edsonpetrinijr/pintura/fotos-referencia/pintura-03.jpg

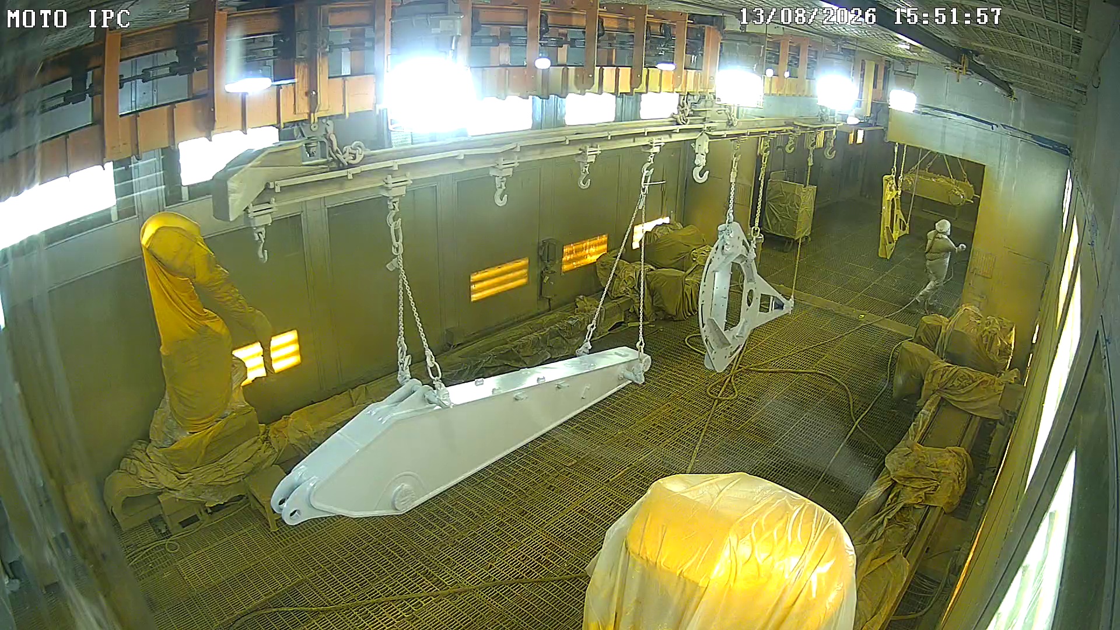
fotos-referencia/pintura-03.jpg
