edsonpetrinijr/pintura/fotos-referencia/pintura-01.jpg

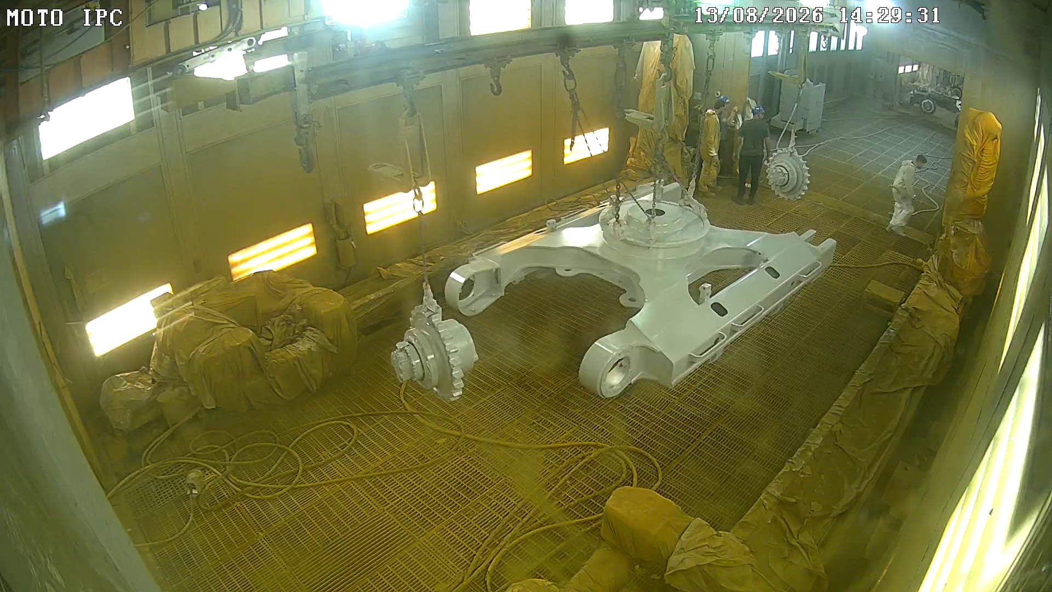
fotos-referencia/pintura-01.jpg
