edsonpetrinijr/pintura/fotos-referencia/pintura-02.jpg

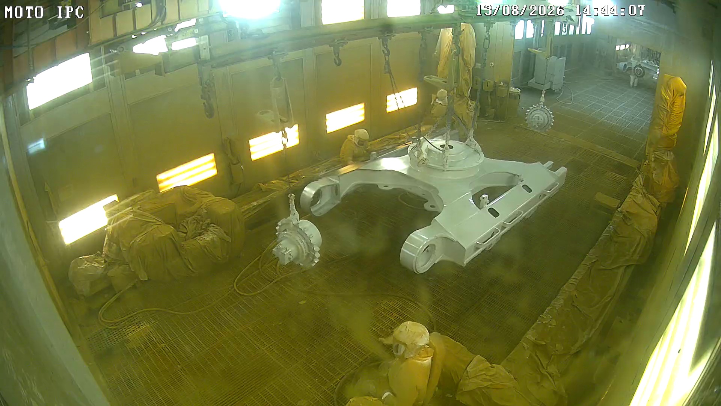
fotos-referencia/pintura-02.jpg
