edsonpetrinijr/pintura/modelos/5958940-01-STICK AS (View).stp

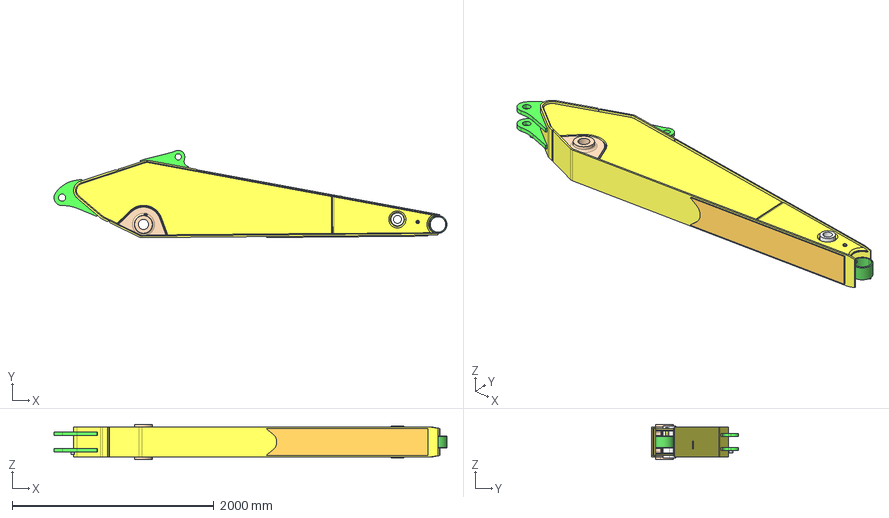
[picture p4: CAD file, 2026-08-14]
modelos/5958940-01-STICK AS (View).stp
3895.9 x 866.1 x 349.0 mm
5824531_VG01_00_PLATE
5824530_VG01_00_PLATE
5824527_VG01_01_PLATE
5824528_VG01_01_PLATE
6358060_VG01_00_PLATE
6358061_VG01_00_PLATE
5824532_VG01_01_PLATE
5824529_VG01_01_PLATE
6358064_VG01_00_PLATE x 2
6358056_VG01_00_PLATE x 2
4835117_01_TUBE
4835116_03_BOSS x 2
4719366_VG01_03_PLATE
4414043_01_PLATE x 2
4i1232_03_PLATE x 4
4719367_02_PLATE x 5
5388532_VG01_00_PLATE x 2
6c1886_m_00_PLATE
5806918_00_BOSS
4i1233_05_BOSS x 2
4i0523_03_TUBE
4719410_01_BOSS
1304477_01_PLATE
