edsonpetrinijr/pintura/modelos/6337098-03-FRAME AS-UPPER (View).stp

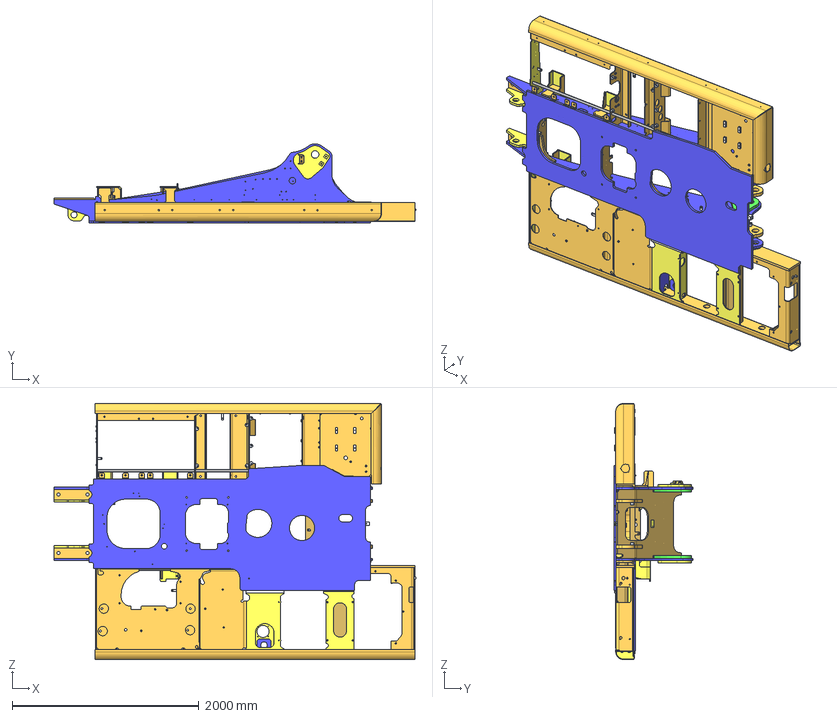
[picture p6: CAD file, 2026-08-14]
modelos/6337098-03-FRAME AS-UPPER (View).stp
3872.0 x 849.3 x 2740.0 mm
5074863_07_PLATE
5074945_05_PLATE
5074946_04_PLATE
5074866_02_PLATE
5074867_03_PLATE
5074868_04_PLATE
5074954_02_PLATE x 2
4324832_01_PLATE x 2
4324833_01_PLATE x 2
5713386_01_PLATE x 2
5074944_01_PLATE
4324835_01_PLATE
5074871_01_PLATE x 2
5133018_01_PLATE
5133019_01_PLATE
5074797_SK01_09_FRAME_AS_SKIRT
5074873_04_CHANNEL
5074874_03_PLATE
5074876_02_PLATE
5074877_01_PLATE
5074885_01_PLATE
5074886_02_PLATE
5074887_03_PLATE
5074897_03_PLATE
5074875_02_PLATE
5074878_01_PLATE
5074889_05_PLATE
5909381_00_PLATE
5074891_03_PLATE
5074892_03_PLATE
5074894_06_PLATE
3439221_02_PLATE
5074898_01_PIPE
5074899_02_PIPE
5074902_01_PLATE
5074903_01_PLATE
4198336_00_PLATE x 4
4644852_00_PLATE x 4
5622209_02_PLATE
5443761_00_PLATE x 4
5622212_04_PLATE
5074798_SK01_04_FRAME_AS_SKIRT
5074904_04_CHANNEL
5074905_03_CHANNEL
5074906_03_PLATE
5074907_02_PLATE
5074908_01_PLATE
5074910_03_PLATE
5074921_01_PIPE
5074912_02_PLATE
5074951_02_PLATE
5074909_05_PLATE
5074911_02_PLATE
5074913_04_PLATE
5074914_02_PLATE
5074915_02_PLATE
5074917_03_PLATE
5074920_05_PLATE
1056407_M_01_PLATE x 4
5074919_02_PLATE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
