edsonpetrinijr/pintura/modelos/_antigos/6272878-01-BLADE AS (View).stp

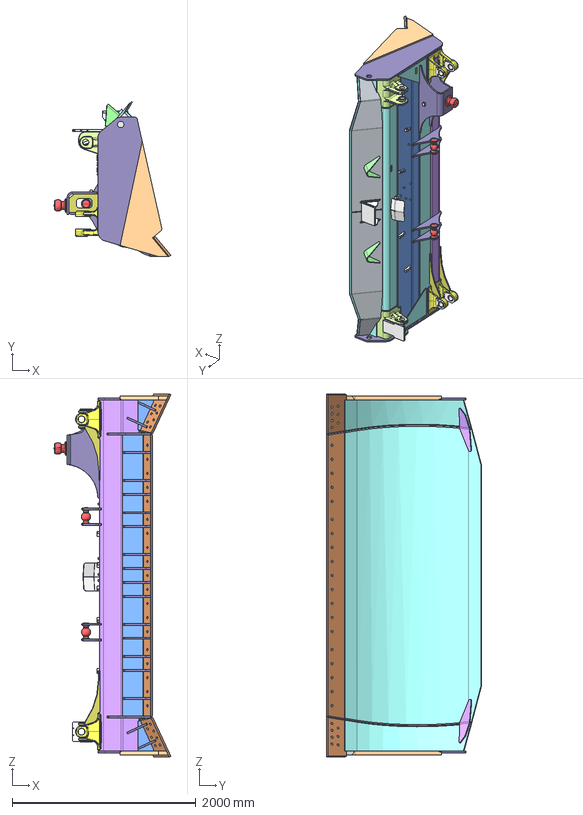
[picture p7: CAD file, 2026-08-14]
modelos/_antigos/6272878-01-BLADE AS (View).stp
1270.1 x 1687.2 x 3948.3 mm
4598336_02_SUPPORT_CENTER
4602368_02_SUPPORT_OUTSIDE x 2
4598337_01_MOLDBOARD_CENTER
4598338_01_MOLDBOARD_LH
4598339_01_MOLDBOARD_RH
5227582_00_CHANNEL
5227583_01_CHANNEL
5225561_00_BRACKET_RH
5225562_00_BRACKET_LH
5227585_01_CHANNEL
5313579_00_PLATE_LH
5227587_02_PLATE x 2
5313580_00_PLATE_RH
4598351_02_PLATE x 4
4598352_02_PLATE x 2
4598353_02_PLATE x 2
4598355_02_PLATE
4724234_02_PLATE x 10
5227602_01_PLATE x 6
5227603_01_PLATE x 2
4598357_03_PLATE
5227590_01_PLATE
5227591_00_GUSSET x 14
5227592_00_GUSSET x 2
2394194_05_GUSSET x 2
2120827_04_GUSSET x 2
5227593_00_PLATE_LH
5227594_00_PLATE_RH
4598362_02_PLATE_REAR
2305566_05_PLATE x 4
9j0123_14_TRUNNION x 2
1088293_03_BRACKET x 2
3g9598_CL00_BEARING_SLEEVE x 4
5227598_00_PLATE
5227599_00_PLATE
1102966_02_TRUNNION
5227600_00_PLATE
5227595_00_PLATE x 3
5227596_00_PLATE
5227597_00_PLATE
4724237_01_PLATE_RH
4724238_01_PLATE_LH
1u0183_02a_DEFLECTOR x 2
4343129_01_PLATE x 2
2519822_03_BLOCK x 6
8p9770_02_PLATE x 2
6024738_01_GUARD
__REMOTE_OBJECT__ x 3
5932057_01_BLOCK
4580118_00_PLATE
2454245_02_PLATE
4505798_00_PLATE x 2
3934886_01_PLATE
