edsonpetrinijr/pintura/modelos/5756942-02-ARM AS-LIFT (View).stp

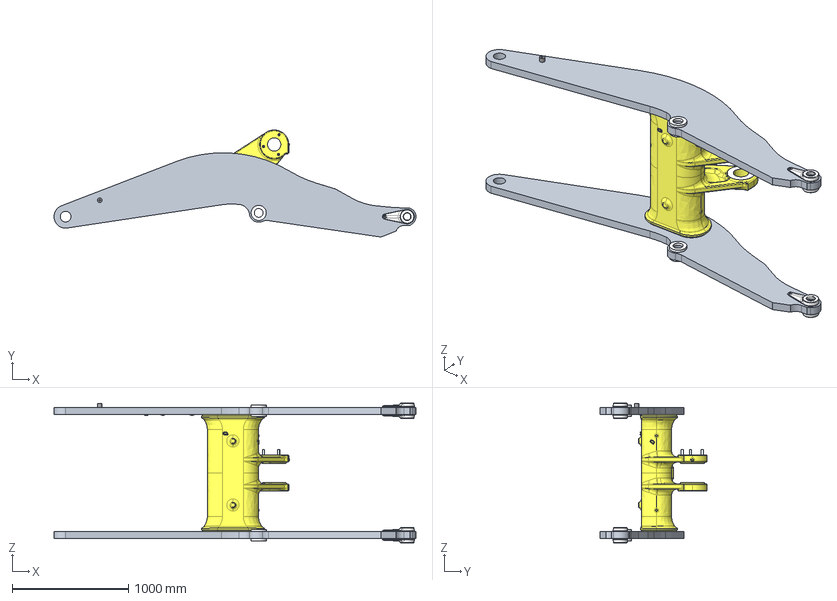
[picture p8: CAD file, 2026-08-14]
modelos/5756942-02-ARM AS-LIFT (View).stp
3111.8 x 920.7 x 1199.5 mm
3380144_05_CROSSMEMBER
1291476_L_CL00_BOSS x 4
1371973_02_BOSS x 4
4890252_01_BOSS x 4
1061139_CL00_BOSS
1168026_CL00_BLOCK_WELD
