edsonpetrinijr/pintura/modelos/4436041-04-TANDEM GP (View).stp

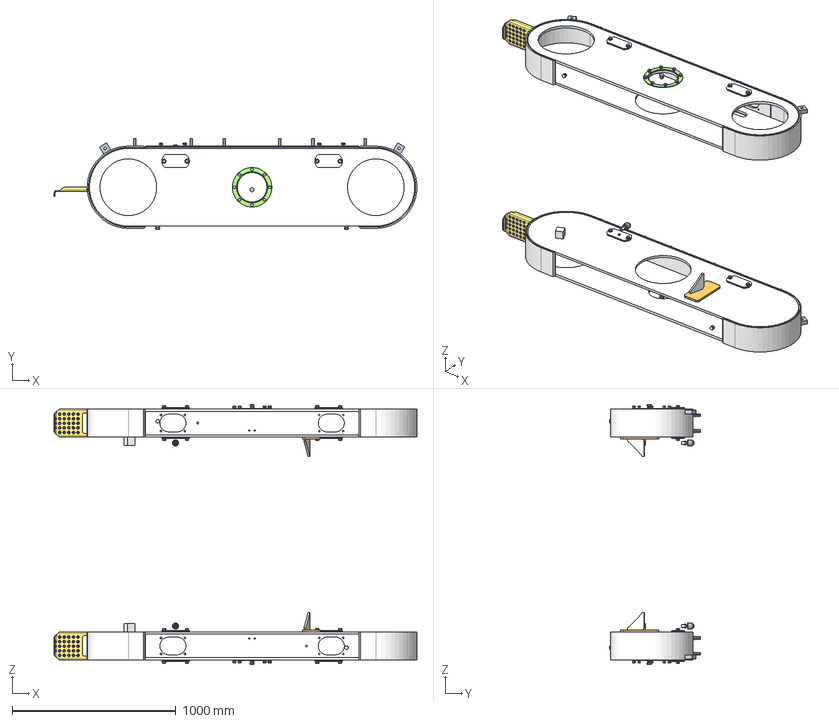
[picture p9: CAD file, 2026-08-14]
modelos/4436041-04-TANDEM GP (View).stp
2214.5 x 552.4 x 1586.9 mm
4436041_SK01_01_TANDEM_GP_COVER_
2675022_05_PLATE x 2
4698363_01_PLATE x 2
8x3411_04_PLATE x 4
2675024_08_PLATE x 2
__REMOTE_OBJECT__ x 2
4218697_00_PLATE x 2
8b1223_06_BOSS x 2
8d6684_CL00_BAR x 2
4381550_01_GUSSET x 2
9d0566_01_PLATE x 2
3w9030_CL00_BOSS x 8
8c8499_CL00_BOSS_WELD x 24
2768085_00_PLATE x 2
5114657_01_STEP x 2
2G9789_VG01_00_GASKET x 4
2520964_01_PLATE x 4
2B3147_03_GASKET x 8
2481371_02_COVER x 2
0026453_CL00_ELBOW_PIPE x 2
6b5072_CL00_BUSHING_REDUCING x 2
4h6112_08_BREATHER_AS x 2
2b3148_05_COVER x 6
2g9791_CL00_GASKET x 2
2a6938_05_COVER x 2
3048032_M_00_PLUG_STOR x 2
