edsonpetrinijr/pintura/(commit log)

2026-08-14 Initial commit: pintura error-proofing CV project (code only, datasets/models excluded)
    [3936315-12-FRAME AS-MTG (View).stp, 4436041-04-TANDEM GP (View).stp, 5756942-02-ARM AS-LIFT (View).stp, 5958940-01-STICK AS (View).stp, 6272878-01-BLADE AS (View).stp, 6337098-03-FRAME AS-UPPER (View).stp, tabela_pecas_ganchos.csv]
2026-08-14 docs: adiciona fotos de referencia do processo de pintura
